GeorgeWilkins/Active-Belt-Tensioner/(list of files, cad)

Other CAD files:
Parts/Acrylic/DXF/Belt Loop, B (3mm x 2).dxf
Parts/Aluminium/DXF/Cooling Plate (0.25in x 2).dxf
Parts/Acrylic/DXF/Belt Loop, C (3mm x 2).dxf
Parts/Acrylic/DXF/Belt Loop, A (3mm x 2).dxf
Parts/Acrylic/DXF/Protoboard Tray, A (3mm x 1).dxf
Parts/Acrylic/DXF/Rear Panel, A (3mm x 1).dxf
Parts/Acrylic/DXF/Front Panel, B (3mm x 1).dxf
Parts/Acrylic/DXF/Pulley, A (3mm x 8).dxf
Parts/Acrylic/DXF/Protoboard Tray, B (3mm x 4).dxf
Parts/Acrylic/DXF/Rear Panel, B (3mm x 2).dxf
Parts/Acrylic/DXF/Rear Panel, C (3mm x 1).dxf
Parts/Acrylic/DXF/Pulley, B (3mm x 2).dxf
Parts/Acrylic/DXF/Front Panel, A (3mm x 2).dxf
Design.skp
