GeorgeWilkins/Active-Belt-Tensioner/(commit log)

2025-01-11 Filling Out BOM
2025-01-11 Adding Arduino Sketch
2025-01-11 Adding Device JS
2025-01-11 Adding Device Settings
2025-01-11 Adding Source File Links, Adding Clamps
2025-01-12 Adding DXF Files
    [Belt Loop, A (3mm x 2).dxf, Belt Loop, B (3mm x 2).dxf, Belt Loop, C (3mm x 2).dxf, Front Panel, A (3mm x 2).dxf, Front Panel, B (3mm x 1).dxf, Protoboard Tray, A (3mm x 1).dxf, Protoboard Tray, B (3mm x 4).dxf, Pulley, A (3mm x 8).dxf]
2025-01-12 Removing Relocated Files, Adding Belt Loops
2025-01-12 Relocating Parts
    [Belt Loop, A (3mm x 2).dxf, Belt Loop, B (3mm x 2).dxf, Belt Loop, C (3mm x 2).dxf, Cooling Plate (0.25in x 2).dxf, Front Panel, A (3mm x 2).dxf, Front Panel, B (3mm x 1).dxf, Protoboard Tray, A (3mm x 1).dxf, Protoboard Tray, B (3mm x 4).dxf]
2025-01-12 Updating Custom Device Configuration
2025-01-12 Adding Sketchup Design File
    [Design.skp]
